LPaulson1985/EnviroTrack-Node/sensornode/sensornode_esp32/esp32_sensornode.png

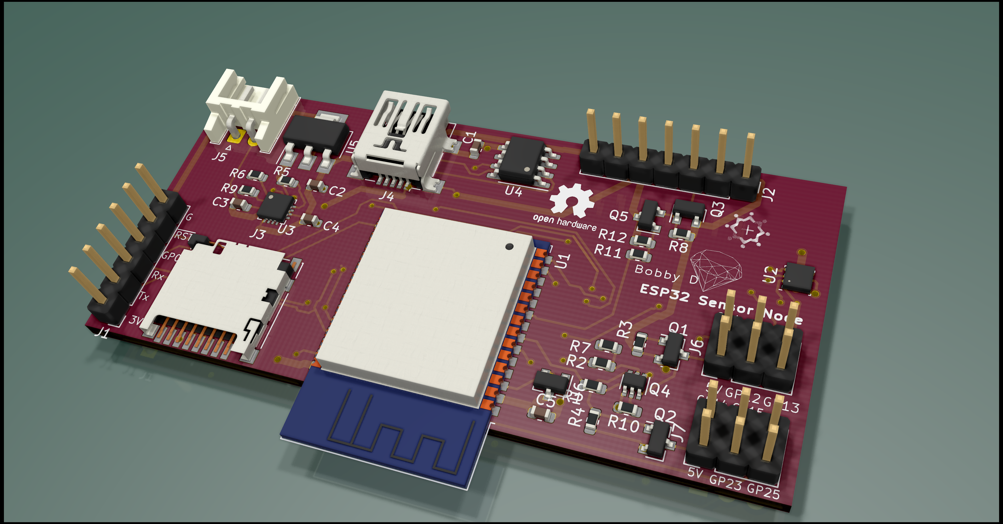
sensornode/sensornode_esp32/esp32_sensornode.png
