LPaulson1985/EnviroTrack-Node/(commit log)

2020-03-31 update to latest board
    [esp32_sensornode.kicad_pcb, esp32_sensornode.sch]
2020-04-01 add lcsc part numbers
    [esp32_sensornode.csv, esp32_sensornode.kicad_pcb, esp32_sensornode.sch]
2020-04-01 position file
    [esp32_sensornode.kicad_pcb, esp32_sensornode.sch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]
2020-04-01 add gerbers and drills
    [esp32_sensornode-B_Cu.gbr, esp32_sensornode-B_Mask.gbr, esp32_sensornode-B_Paste.gbr, esp32_sensornode-B_SilkS.gbr, esp32_sensornode-Edge_Cuts.gbr, esp32_sensornode-F_Cu.gbr, esp32_sensornode-F_Mask.gbr, esp32_sensornode-F_Paste.gbr]
2020-04-05 create files for ordering
    [esp32_sensornode-B_Cu.gbr, esp32_sensornode-B_Mask.gbr, esp32_sensornode-B_Paste.gbr, esp32_sensornode-B_SilkS.gbr, esp32_sensornode-Edge_Cuts.gbr, esp32_sensornode-F_Cu.gbr, esp32_sensornode-F_Mask.gbr, esp32_sensornode-F_Paste.gbr]
2020-04-11 update parts to use all 0603, move labels to be legible
    [esp32_sensornode-B_Cu.gbr, esp32_sensornode-B_Mask.gbr, esp32_sensornode-B_Paste.gbr, esp32_sensornode-B_SilkS.gbr, esp32_sensornode-Edge_Cuts.gbr, esp32_sensornode-F_Cu.gbr, esp32_sensornode-F_Mask.gbr, esp32_sensornode-F_Paste.gbr]
2020-07-05 fix comments and move warmup code
    [pm.ino]
